mabooo18/Hunstat2/Software/README.md

## Files in this folder

- Arduino libraries: This folder includes the three files required for the HunStat2 firmware.
Copy these files into your local Arduino/libraries/ folder before compiling and uploading the firmware to the microcontroller.
- [AD5941_25.zip](AD5941_25.zip): This ZIP archive contains the complete Arduino project, including the .ino, .cpp, and header files required to compile and upload the HunStat2 firmware.
- [HunStat2-v700.exe](HunStat2-v700.exe):This is the Windows installer for the HunStat2 graphical user interface (GUI), which serves as the main program for controlling the potentiostat.
