mabooo18/Hunstat2/laporan/FLOWCHART.md

# Flowchart Panggilan Kode (Call Flow Chart)

Diagram di bawah ini menggambarkan bagaimana modul-modul program saling berinteraksi, mulai dari file utama (**Main Orchestrator**), parser perintah serial (**Communication Layer**), hingga ke submodul **Hardware** dan **Metode Elektrokimia** di dalam folder `src/`.

---

## Diagram Alur Arsitektur (Mermaid Flowchart)

```mermaid
graph TD
    %% Styling Node Warna Premium
    classDef main fill:#1E293B,stroke:#38BDF8,stroke-width:2px,color:#FFF;
    classDef comm fill:#0F766E,stroke:#0D9488,stroke-width:2px,color:#FFF;
    classDef methods fill:#1D4ED8,stroke:#3B82F6,stroke-width:2px,color:#FFF;
    classDef hw fill:#701A75,stroke:#D946EF,stroke-width:2px,color:#FFF;
    classDef utils fill:#7C2D12,stroke:#F97316,stroke-width:2px,color:#FFF;

    %% Definisi Node
    INO["AD5941_25.ino (Loop Utama)"]:::main
    Comm["C_Communication::ReadAndProcess()<br>(src/communication/)"]:::comm
    CV_Main["cv.cpp (cvSetup & Run)"]:::main
    
    CA["c_ca.cpp<br>(C_CA::Run)"]:::methods
    SWV["c_swv.cpp<br>(C_SWV::Run)"]:::methods
    DPV["c_dpv.cpp<br>(C_DPV::Run)"]:::methods
    EIS["c_eis.cpp<br>(C_EIS::Run)"]:::methods
    OCP["c_ocp.cpp<br>(C_OCP::Measure)"]:::methods
    
    Ramp["rampTest.cpp<br>(AppRAMPInit / AppRAMPISR)"]:::methods
    
    WG["wave_gen.cpp<br>(Hardware_Do_WaveGen)"]:::hw
    ADC["adc_control.cpp<br>(init_AD5940_ADC)"]:::hw
    GC["gain_control.cpp<br>(Hardware_FindOptimum_Rf_PGA)"]:::hw
    
    Util["utilities.cpp<br>(ToFloat / Status LED)"]:::utils
    Storage["data_storage.cpp<br>(Global g_Data)"]:::utils

    %% Alur Hubungan (Call Hierarchy)
    INO -->|1. Polling Serial secara berkala| Comm
    
    %% Cabang Pengiriman Command
    Comm -->|2a. Jalankan CA| CA
    Comm -->|2b. Jalankan SWV| SWV
    Comm -->|2c. Jalankan DPV| DPV
    Comm -->|2d. Jalankan EIS| EIS
    Comm -->|2e. Jalankan OCP| OCP
    Comm -->|2f. Jalankan CV M| CV_Main
    
    %% Alur CV via Sequencer
    CV_Main -->|3. Siapkan Sequencer| Ramp
    Ramp -->|4. Trigger hardware WUPT timer| AFE_Seq["AD5941 SRAM Sequencer"]:::hw
    AFE_Seq -->|5. Interrupt Pin A2 Aktif| ISR_Call["XIAOPort.cpp (Falling ISR)"]:::hw
    ISR_Call -->|6. Panggil Handler| Ramp
    
    %% Interaksi ke Hardware/PGA/Filter
    EIS -->|Set sinyal AC sinus| WG
    WG -->|Optimasi otomatis Gain| GC
    EIS -->|Set Sinc filters / DFT| ADC
    
    %% Parsing Data & Dekode 18-bit signed
    CA -->|7. Dekode biner| Util
    SWV -->|7. Dekode biner| Util
    DPV -->|7. Dekode biner| Util
    OCP -->|7. Dekode biner| Util
    EIS -->|7. Dekode biner| Util
    Ramp -->|7. Dekode biner| Util
    
    %% Penyimpanan koordinat data
    CA -->|8. Simpan data| Storage
    SWV -->|8. Simpan data| Storage
    DPV -->|8. Simpan data| Storage
    OCP -->|8. Simpan data| Storage
    EIS -->|8. Simpan data| Storage
    Ramp -->|8. Simpan data| Storage
    
    Storage -->|9. Kirim koordinat ke serial| Host["Komputer / Python UI"]:::main
```

---

## Penjelasan Alur Interaksi

1. **Orkestrator Utama (`AD5941_25.ino`)**:
   * Menjalankan fungsi `loop()` secara terus-menerus.
   * Melakukan polling ke `C_Communication::ReadAndProcess()` untuk membaca perintah yang dikirim komputer lewat USB Serial.

2. **Parser Perintah (`src/communication/`)**:
   * Membaca buffer serial dan membagi perintah (tokenisasi).
   * Melakukan *routing* panggilan langsung ke kelas metode elektrokimia yang sesuai di `src/electrochemical_methods/` (seperti `c_eis.cpp`, `c_ca.cpp`, dll).

3. **Metode Non-Ramp (CA, SWV, DPV, OCP, EIS)**:
   * Mengatur bias tegangan sel menggunakan Low-Power DAC secara langsung.
   * Menghubungi modul hardware untuk inisialisasi filter (`adc_control.cpp`) atau generator gelombang AC (`wave_gen.cpp`).
   * Menunggu jeda kimiawi (*settling delay*).
   * Membaca hasil register konversi ADC, mengubah nilai biner 18-bit ke bentuk float voltase/arus (`utilities.cpp`), menyimpannya di memori (`data_storage.cpp`), lalu mengirimkannya ke Serial.

4. **Metode Ramp (Cyclic Voltammetry / CV)**:
   * Karena memerlukan kecepatan tinggi, CV memanggil konfigurasi di `cv.cpp` yang meneruskannya ke mesin sequencer `rampTest.cpp`.
   * Perintah dirangkai langsung di memori SRAM AD5941. Saat berjalan, chip mengaktifkan jalur interrupt MCU (`A2`) setiap kali selesai membaca step.
   * Fungsi `AppRAMPISR()` mengambil data dari FIFO chip, merata-ratakannya, lalu melakukan konversi dan penyimpanan.

---

## Catatan Tambahan (hasil verifikasi kode terbaru)

Dua hal berikut tidak terlihat dari diagram di atas karena diagram hanya menggambarkan jalur pemanggilan yang **aktif**:

1. **Jalur mati yang ikut ter-compile tapi tidak pernah dipanggil.** Selain `Comm` (`src/communication/communication.cpp`, jalur yang benar-benar dijalankan oleh `AD5941_25.ino`), ada satu set implementasi lama yang duplikat: `src/command_processing/command_processing.cpp` (parser serial versi prosedural) dan bagian atas `src/electrochemical_methods/electrochemical_methods.cpp` (fungsi bebas `RunCA`/`RunSWV`/`RunDPV`). Arduino tetap meng-compile kedua file ini karena berada di dalam folder sketch, tapi tidak ada satu pun pemanggil di `loop()` yang mengarah ke sana — jadi keduanya tidak pernah tereksekusi. Selengkapnya di `ARCHITECTURE_DOCUMENT.md` §3.4/§8 dan `TECHNICAL_REPORT_EN.md` §5.
2. **Transport SPI ke AD5941 sekarang bit-banged, bukan `SPI` hardware bawaan RP2040.** Node `XIAOPort.cpp` di diagram di atas kini mengimplementasikan SPI Mode 0 secara manual lewat `digitalWrite`/`digitalRead` pada pin `D8`/`D9`/`D10`, karena wiring board ini menukar posisi MISO/MOSI dibanding pin-mux SPI0 bawaan XIAO RP2040. Detail lengkap di `TECHNICAL_REPORT_EN.md` §4.1 dan §7.4.

---

# Part 2 — How the AD5941 Actually Works (Signal-Level Flowcharts)

The diagrams above describe the *software* call graph — which function calls which. This part is a different, complementary view: how a voltage command actually becomes a physical measurement, tracing signal flow through the PC, the microcontroller, the AD5941's internal analog blocks, the electrode connector, and the electrochemical cell itself. It mirrors the block-diagram set from the project's internal "Update Potensiostat" presentation, redrawn here in English and cross-checked line-by-line against the firmware described in Part 1 and in `ELECTROCHEMICAL_METHODS_EXPLANATION.md` / `TECHNICAL_REPORT_EN.md`.

## 1. System Block Diagram

```mermaid
graph TD
    subgraph PC[PC Software - HunStat2 Windows GUI]
        CVtab[CV tab]
        OCPtab[OCP tab]
        EIStab[EIS tab]
        SPtab[Signal processing tab]
    end

    MCU[Microcontroller - Seeed XIAO RP2040<br/>runs the Arduino sketch, bit-banged SPI interface]

    subgraph AFE[AD5941 Analog Front End chip]
        DAC[DAC<br/>Vzero six bit plus Vbias twelve bit]
        WG[Waveform Generator<br/>DC ramp or AC sine, 0.2 Hz to 200 kHz]
        TIA[TIA - transimpedance amplifier<br/>converts cell current to a voltage]
        ADCPGA[ADC plus PGA<br/>16 bit sigma delta ADC, five gain steps]
        DFT[DFT / DSP engine<br/>computes Z real and Z imag for EIS]
        LOOP[Potentiostat control loop<br/>CE driver regulates the WE potential]
        PWR[Power management<br/>LDO and bandgap bias references]
    end

    subgraph PASSIVE[Board level passive components]
        DECAP[Decoupling capacitors]
        FBRES[Feedback resistors, including RCAL]
        EMI[EMI filter inductor]
        JUMP[Zero ohm jumpers]
        SW[Tactile switches]
    end

    subgraph ELEC[Electrode interface - 3 pin SPE connector]
        WE[WE - working electrode]
        CE[CE - counter electrode]
        RE[RE - reference electrode]
    end

    CELL[Electrochemical cell or Screen-Printed Electrode<br/>for example a carbon or gold SPE]

    PC -- USB-C --> MCU
    MCU -- SPI --> DAC
    DAC --> WG --> TIA --> ADCPGA
    ADCPGA --> DFT
    LOOP -.regulates.-> WG
    PWR -.powers.-> DAC
    ADCPGA --> DECAP
    DECAP --> FBRES --> EMI --> JUMP --> SW
    SW --> WE
    SW --> CE
    SW --> RE
    WE --> CELL
    CE --> CELL
    RE --> CELL
```

Compared to the presentation slide this is redrawn from: the ADC/PGA block there is captioned "gain 1 to 512", but the firmware actually only exposes five discrete PGA steps (1.0x, 1.5x, 2.0x, 4.0x, 9.0x — `gain_control.cpp`'s `pga_values[]`). The wider number almost certainly refers to the *combined gain* range achievable once the eight TIA feedback resistor steps (200 Ω … 160 kΩ) are multiplied in — see `TECHNICAL_REPORT_EN.md` §3.4 for the exact interpolation formula used to pick both automatically.

## 2. Excitation Signal Path (PC to Cell)

```mermaid
graph LR
    GUI[PC GUI<br/>parameters: E start, E end, frequency, delta E]
    PARSE[RP2040 MCU<br/>parses the serial command, relays it over SPI]
    DAC2[DAC inside the AD5941<br/>Vzero six bit / Vbias twelve bit]
    WG2[Waveform generator]

    GUI -- USB-C command --> PARSE
    PARSE -- SPI register writes --> DAC2
    DAC2 -- analog voltage --> WG2

    WG2 --> RAMP[DC ramp or staircase<br/>used by CV, DPV, OCP]
    WG2 --> SINE[AC sinusoidal<br/>used by EIS, 0.2 Hz to 200 kHz]
    WG2 --> PULSE[Staircase plus pulse<br/>used by DPV and SWV]

    RAMP --> PLOOP[Potentiostat loop<br/>CE driver holds the WE at the target potential]
    SINE --> PLOOP
    PULSE --> PLOOP

    PLOOP -- excitation E of t --> CELL2[CE and WE pins on the SPE<br/>excitation delivered to the cell]
```

This matches the firmware's per-method `ConfigDCMeasurement()`/`Hardware_Do_WaveGen()` split described in `ELECTROCHEMICAL_METHODS_EXPLANATION.md`: CA/DPV/SWV/OCP drive a static or stepped DC level through the `WGTYPE_MMR` path, while EIS drives a continuous sine through `WGTYPE_SIN`. Both paths ultimately write the same `HpLoopCfg.WgCfg` structure.

## 3. Potentiostat Feedback Loop (Detail)

This is the core control loop that makes a *potentiostat* a potentiostat: it forces the working electrode's potential to track a target value by adjusting the counter electrode, rather than by driving the working electrode directly.

```mermaid
graph TD
    subgraph CHIP[Inside the AD5941]
        DAC3[DAC<br/>builds the target E set]
        OPAMP[Op-amp<br/>the CE driver]
        ERR[Error amplifier<br/>compares E RE against E set]
        DAC3 --> OPAMP
    end

    subgraph SPE2[Screen-Printed Electrode - 3 electrodes on 1 substrate]
        CE2[CE - counter electrode]
        WE2[WE - working electrode]
        RE2[RE - reference electrode]
    end

    SOL[Electrolyte solution<br/>ions carry current between electrodes]
    REDOX[Redox reaction at the WE surface<br/>produces the response current I of t]
    TIA2[TIA<br/>current to voltage conversion]
    ADC2[16 bit ADC<br/>digitizes I of t]
    MCUOUT[RP2040 to PC GUI<br/>current data streamed over USB]

    OPAMP -- V CE drives --> CE2
    CE2 --> SOL --> WE2 --> REDOX --> TIA2 --> ADC2 --> MCUOUT
    RE2 -- E RE feedback --> ERR
    ERR -- correction signal --> OPAMP
```

**Why the loop is closed through the reference electrode, not the working electrode:** the whole point of a 3-electrode cell (§1.2 of `ELECTROCHEMICAL_METHODS_EXPLANATION.md`) is that no current is allowed to flow through the RE, so its potential never drifts from Faradaic reactions at its own surface. If `E_RE` measured against `E_set` shows an error, the op-amp keeps adjusting `V_CE` — never `V_WE` directly — until the RE reports the correct potential. All the current needed to sustain that potential is supplied or sunk through the CE instead.

## 4. Generate, React, Detect — The Three-Stage View

A simpler way to see the same loop: as three stages that data flows through once per excitation step (once per CV/DPV/SWV point, or continuously for CA/EIS/OCP sampling).

```mermaid
graph LR
    subgraph GEN[1. GENERATE - build the excitation voltage]
        DACg[DAC inside the AD5941<br/>builds E set: ramp, sine, or staircase]
        DRVg[CE driver op-amp<br/>amplifies and sends it to the CE pin]
        DACg --> DRVg
    end

    subgraph CELL3[2. In the cell - the SPE - reaction happens here]
        CEc[CE<br/>pumps current into the solution]
        WEc[WE<br/>where the reaction of interest happens]
        REc[RE<br/>senses the cell potential]
        SOLc[Electrolyte solution<br/>ion current]
        RXc[Redox reaction<br/>oxidized species plus electron gives reduced species, producing I of t]
        CEc --> SOLc --> WEc --> RXc
    end

    subgraph DET[3. DETECT - read the resulting current]
        TIAd[TIA<br/>current times feedback resistance gives a voltage]
        PGAd[PGA plus 16 bit ADC<br/>amplifies and digitizes, down to roughly 54 pA resolution]
        DFTd[DSP / DFT engine<br/>computes Z real and Z imag, EIS only]
        MCUd[RP2040 MCU<br/>packages the data, sends it over USB-C]
        GUId[PC GUI<br/>plots the voltammogram or Nyquist curve]
        TIAd --> PGAd --> DFTd --> MCUd --> GUId
    end

    DRVg -- V CE to the CE pin --> CEc
    RXc -- current I of t --> TIAd
    REc -- E RE feedback to the comparator --> DRVg
```

**Why three electrodes, in one line each:** CE pumps whatever current the loop needs into the solution; WE is the fixed, characterized surface where the reaction under study actually happens; RE is a low-current sensor that tells the loop what potential the WE is really sitting at, so the loop can correct for it.

## 5. Response Signal Path (Cell back to PC)

```mermaid
graph LR
    WEr[WE on the SPE<br/>outgoing response current I of t]
    TIAr[TIA<br/>current to voltage via the feedback resistor]
    PGAr[PGA plus ADC<br/>selectable gain, 16 bit]
    DFTr[DSP / DFT engine]

    WEr -- I of t, analog current --> TIAr
    TIAr -- V TIA, analog voltage --> PGAr
    PGAr -- 16 bit digital samples --> DFTr

    DFTr --> ItSig[I of t signal - used by CA, CV, DPV, SWV<br/>peak or decay current is extracted directly]
    DFTr --> ZwSig[Z of omega signal - used by EIS<br/>the DFT engine yields Z real plus j Z imag per frequency]
    DFTr --> ESig[E signal - used by OCP<br/>settles to a stable open circuit potential]

    ItSig --> RESULT[Result streamed back to the PC for display and analysis]
    ZwSig --> RESULT
    ESig --> RESULT

    RESULT --> GUIr[PC GUI]
    GUIr --> MCUr[RP2040 MCU]
    MCUr -- plotted / exported data --> SPr[Signal processing tab<br/>Savitzky-Golay filtering or moving average]
```

For CA/SWV/DPV this path runs through `MeasureCurrentRaw()`/`RawToCurrent()` once (CA) or twice (SWV/DPV, forward+reverse or base+pulse) per step — see `ELECTROCHEMICAL_METHODS_EXPLANATION.md` §3–§6. For EIS the same TIA/PGA/ADC hardware feeds the on-chip DFT accelerator instead of a single Sinc2 sample, producing one complex `(Z_real, Z_imag)` pair per frequency point — see §7 there and §3.3/§6 of `TECHNICAL_REPORT_EN.md`.

## 6. Practical Guide — Choosing RCAL, `tia_rf`, and Gain for a Given Sample

The auto-gain formula in `TECHNICAL_REPORT_EN.md` §3.4 picks a TIA resistor and PGA gain automatically from `CGMax`/`CGMin`, but those two limits still have to be set sensibly for the impedance range you actually expect from the sample. `RCAL` (the on-board calibration resistor selected in hardware, decoded to the firmware via `tia_rf`) should be chosen to sit near the middle of the sample's expected impedance range — too small and the TIA output barely moves for the current involved; too large and it saturates.

| RCAL | `tia_rf` (`r`) | `amplitude` (`z`/`Y`) | `_CGmax` (`t`) | `_CGmin` (`u`) | Typical measured Z range | Good for |
|---|---|---|---|---|---|---|
| 3.3 Ω | `r0` (200 Ω) | `z20` (≈8 mV) | 1000 | 300 | ~0.3 Ω – 330 Ω | Metals, carbon electrodes, low-ESR Li-ion cells |
| 4.7 Ω | `r0` (200 Ω) | `z30` (≈12 mV) | 1500 | 400 | ~0.5 Ω – 470 Ω | Batteries, supercapacitors, active corrosion |
| 200 Ω | `r1` (1 kΩ) | `z60`/`Y40`-`Y80` (≈24 mV) | 5000 | 1500 | ~20 Ω – 20 kΩ (sweet spot 100 Ω – 1 kΩ) | Dilute-to-moderate electrolytes (1x PBS ≈100–300 Ω, 0.1 M NaCl ≈200 Ω), impedimetric biosensors, pH/ion-selective electrodes, electrodeposition baths |
| 10 kΩ (default) | `r3` (10 kΩ) | `z126`/`Y126` (≈50 mV) | 30000 | 7500 | ~1 kΩ – 100 kΩ (sweet spot 5 kΩ – 50 kΩ) | Very dilute electrolytes and deionized water, polymer/membrane films (e.g. Nafion), soil/sediment EIS, semiconductor and solar-cell junction characterization |

The `c<value>` serial command sets `fRcal` (the *value* used in the Nyquist math, §6 of `ELECTROCHEMICAL_METHODS_EXPLANATION.md`) — it must match whichever physical RCAL resistor is actually populated on the board, since `C_EIS::CalculateNyquistCurve()` scales every impedance point by `fRcal` directly. Setting `c` to a value that doesn't match the installed resistor produces a Nyquist plot that is correctly *shaped* but wrong in *scale* by a constant factor.
