mabooo18/Hunstat2/update (1 august 26)/laporan/ELECTROCHEMICAL_METHODS_EXPLANATION.md

# How Electrochemical Methods Work in Code (AD5941)

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

---

## 1. What is an Electrochemical Method and How Does It Work?

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

```
       [ Potentiostat Control Feedback Loop ]
                 |                  |
                 v                  v
         +---------------+  +---------------+
         |   RE Pin      |  |    CE Pin     |
         | (Reference)   |  |   (Counter)   |
         +---------------+  +---------------+
                 |                  |
                 v                  v
            ==============================
                  ELECTROCHEMICAL CELL
            ==============================
                          |
                          v
                  +---------------+
                  |    WE Pin     | ----> [ Transimpedance Amp (TIA) ]
                  |   (Working)   |               |
                  +---------------+               v
                                          [ 16-Bit Sigma-Delta ADC ]
                                                  |
                                                  v
                                          [ Raw Digital Code ]
```

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

---

## 2. The Core AD5941 Loop: Voltage Excitation & Current Readback

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

```mermaid
graph TD
    subgraph CHIP[Inside the AD5941]
        DAC3[DAC<br/>builds the target E set]
        OPAMP[Op-amp<br/>the CE driver]
        ERR[Error amplifier<br/>compares E RE against E set]
        DAC3 --> OPAMP
    end

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

    OPAMP -- V CE drives --> CE2
    CE2 --> SOL --> WE2 --> REDOX --> TIA2 --> ADC2 --> MCUOUT
    RE2 -- E RE feedback --> ERR
    ERR -- correction signal --> OPAMP
```

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

### 2.1. What the HSTIA Registers Actually Configure

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

> **A related, still-open gap found 2026-08-01**: the switch-matrix line just above this table, `HpLoopCfg.SWMatCfg.Nswitch = SWN_SE0`, is hardcoded identically in `C_CA`, `C_SWV`, and `C_DPV` — there is no serial command or config path anywhere in the firmware to route a different physical working-electrode pin. A live test against a 3-branch dummy cell (one nonlinear diode branch, two plain-resistor/RC branches — see `UPDATE_2026-08-01.md` §2) produced flat, noisy CA/SWV traces with no discernible peak; the leading hypothesis is that `SE0` isn't wired to the one branch capable of producing a peaked response, which this firmware currently has no way to change without rewiring the board. See `ARCHITECTURE_DOCUMENT.md` §9, item 5.

---

## 3. Chronoamperometry (CA) in Code

**Goal**: Apply a single constant voltage to the cell and record the current decay over time.

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

---

## 4. Cyclic Voltammetry (CV) in Code

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

1. **Setup Parameters**: The variables `V_Start`, `V_Stop`, `EStep` (step size), and `ScanRate` (speed) are configured. **These are all millivolt-scale** (`RampTest.h`'s `DAC12BITVOLT_1LSB = 2200/4095 ≈ 0.537 mV` — every field in `AppRAMPCfg_Type` is mV-based, matching CA/SWV/DPV's convention elsewhere in this document). A 2026-08-01 bug in the Python UI sent these four fields in volts instead — e.g. `0.5` instead of `500` — which collapsed a normal ~700-point sweep down to exactly 2 points, since the step-count formula below effectively saw a sub-1mV total voltage swing. Fixed on the UI side (`hunstat2_test_ui.py` now converts V→mV before sending); see `UPDATE_2026-08-01.md` §3.1 for the full derivation.
2. **Sequencer Compilation (`AppRAMPInit`)**:
   * The code calculates the list of voltage steps from start to peak and back.
   * It compiles sequencer command blocks:
     * **SEQ0/SEQ1**: Commands instructing the AFE to write a new voltage step code directly to the LP-DAC register, wait for settling, and sleep.
     * **SEQ2**: Commands instructing the AFE to wake up and turn on the ADC.
3. **Trigger Sweeps (`AppRAMPCtrl`)**:
   * The **Wakeup Timer (WUPT)** is configured to run at intervals matching the scan rate.
   * On every timer tick, the hardware runs the compiled sequences:
     `Update Voltage (SEQ0/SEQ1) -> Wait Settling -> Start ADC (SEQ2) -> Capture Data`
4. **Interrupt Handling (`AppRAMPISR`)**:
   * Each time a step completes, the AFE pulls the microcontroller's interrupt pin (`A2`) LOW.
   * The RP2040 runs `AppRAMPISR()`:
     * It reads the raw samples out of the AFE's FIFO buffer.
     * It averages the samples to remove high-frequency noise.
     * It prints the resulting Voltage vs. Current coordinate over Serial.

---

## 5. Square Wave Voltammetry (SWV) in Code

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

```
Voltage
  ^
  |          Forward Pulse (V_forward = V_step + Amplitude)
  |            _
  |          /   \
  |         |     |
  |    _____|     |_____  <- Staircase Step (V_step)
  |               |     |
  |                \   /
  |                  -    <- Reverse Pulse (V_reverse = V_step - Amplitude)
  +------------------------------------------------------------> Time
```

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

---

## 6. Differential Pulse Voltammetry (DPV) in Code

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

```
Voltage
  ^
  |                       Pulse (V_pulse = V_step + Amplitude)
  |                         ________
  |                        |        |
  |                        |        |
  |    ____________________|        |____  <- Staircase Step (V_step)
  |    ^                            ^
  |    |                            |
  |  Sample Base Current          Sample Pulse Current
  |   (I_base)                     (I_pulse)
  +------------------------------------------------------------> Time
```

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

---

## 7. Electrochemical Impedance Spectroscopy (EIS) in Code

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
