mabooo18/Hunstat2/Software/update 4 (8 Agustus 26)/AD5941_25/ppt gambar.pdf

# Update Potensiostat

Dipresentasikan oleh

KENT

### 30 MEI 26

Daftar Isi:
1.Dokumen (diagram blok, RCAL)
2. Foldering Software
3. Laporan jasa Potensiostat

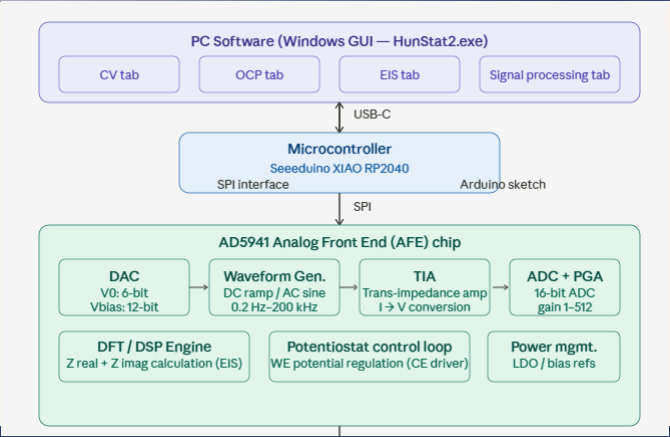
[picture p12: figure]

### 1. Dokumen (Diagram Blok)

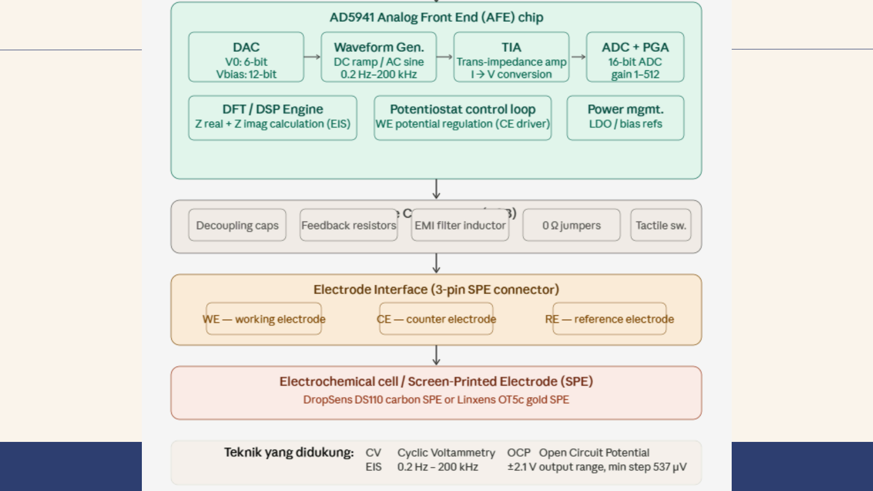
[picture p13: page 4]
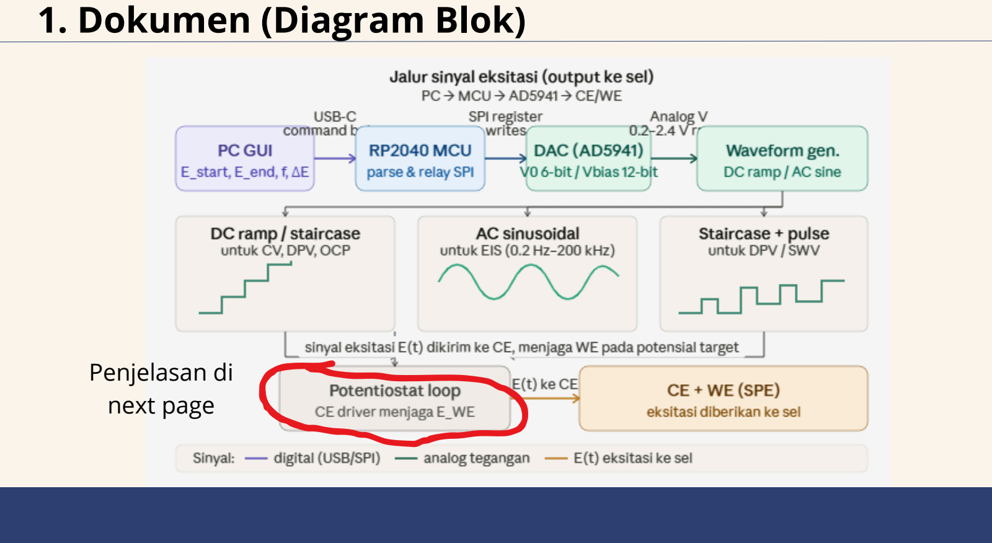
[picture p14: page 5]

### 1. Dokumen (Diagram Blok)

Penjelasan di
next page

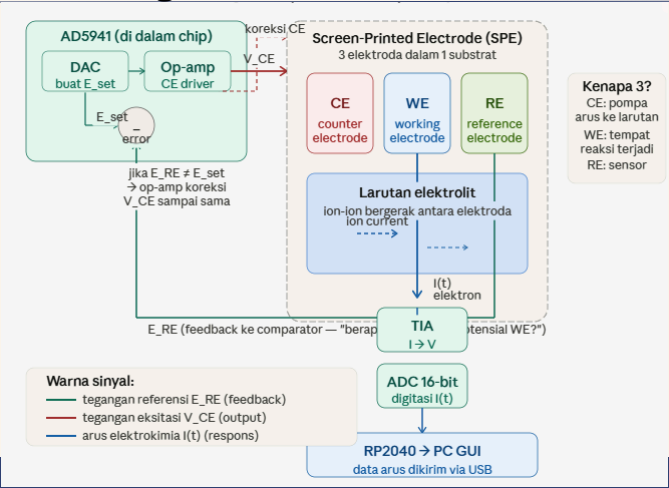
[picture p15: figure]

### 1. Dokumen (Diagram Blok)

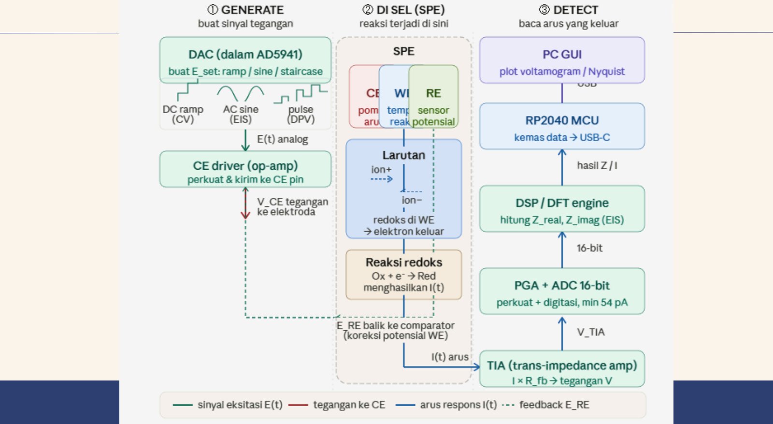
[picture p16: page 7]

### 1. Dokumen (Diagram Blok)

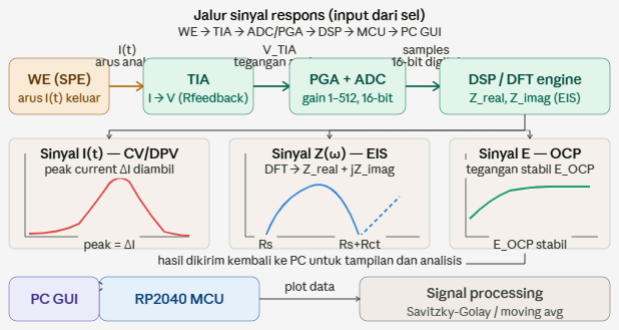
[picture p17: figure]

### 1. Dokumen (RCAL)

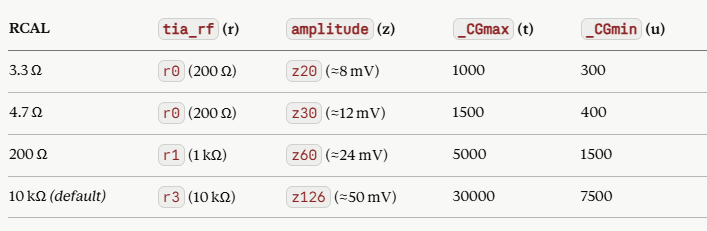
[picture p18: figure]

### 1. Dokumen (RCAL)

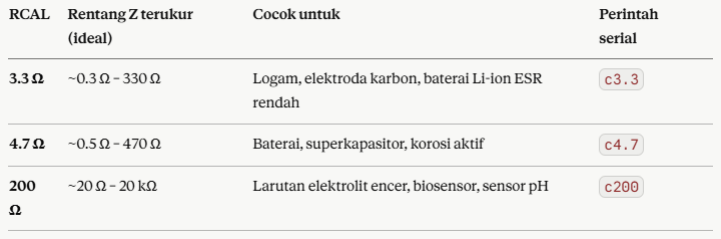
[picture p19: figure]
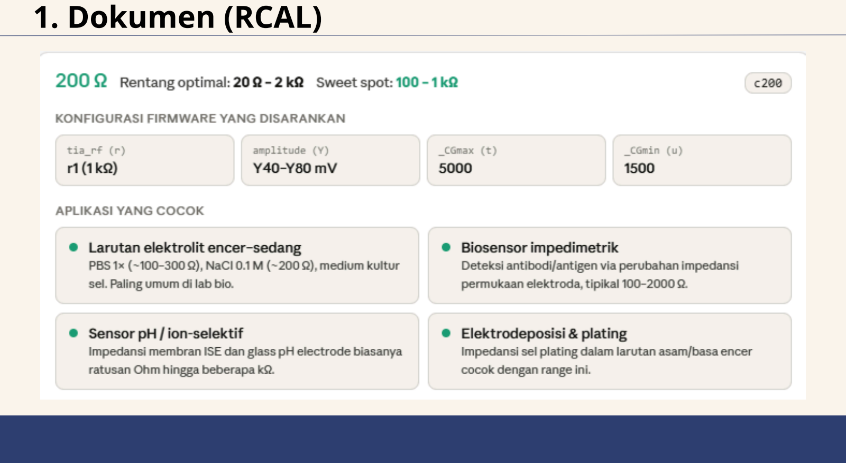
[picture p20: page 11]

### 1. Dokumen (RCAL)

### 1. Dokumen (RCAL)

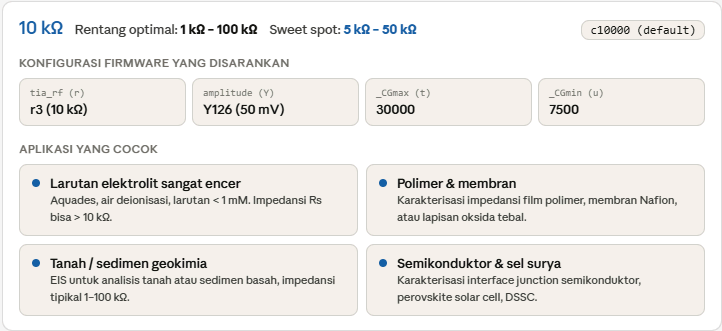
[picture p21: figure]

2.Foldering Software

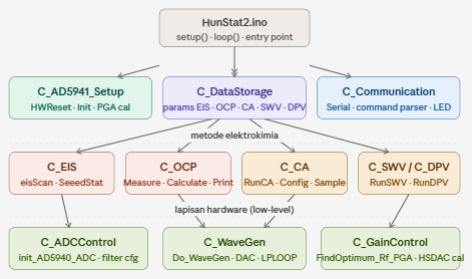
[picture p22: figure]

2.Foldering Software

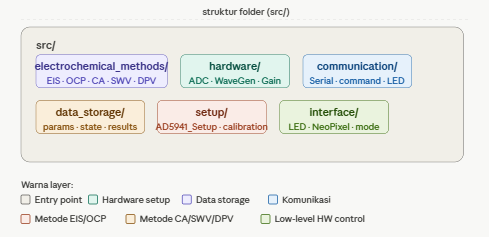
[picture p23: figure]
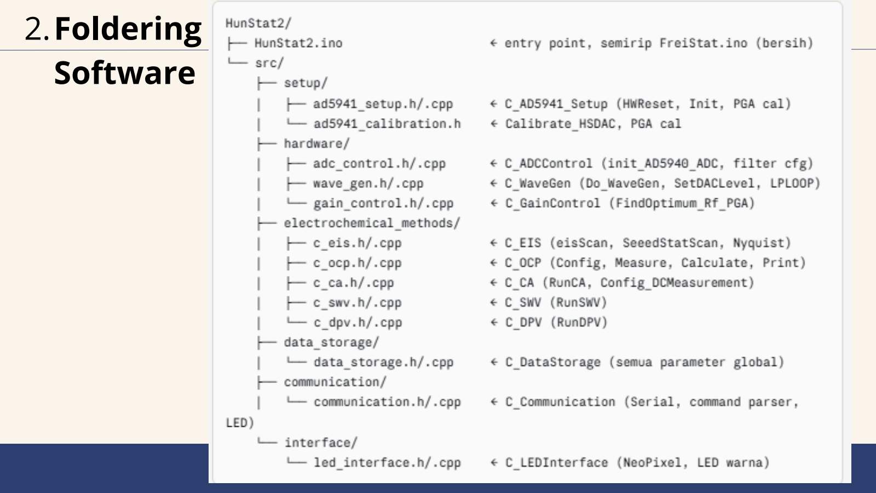
[picture p24: page 15]

2.Foldering
Software

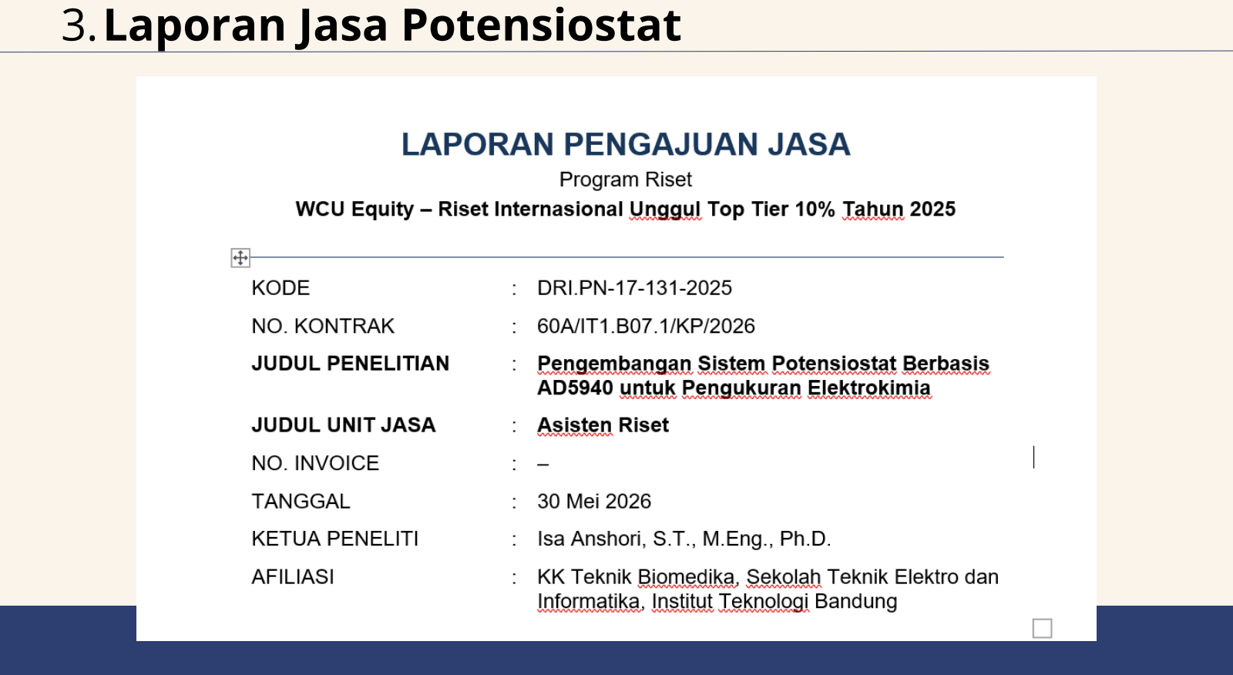
[picture p25: page 16]

3.Laporan Jasa Potensiostat
