mabooo18/Hunstat2/Software/update 4 (8 Agustus 26)/AD5941_25/hasil/dummy cell.png

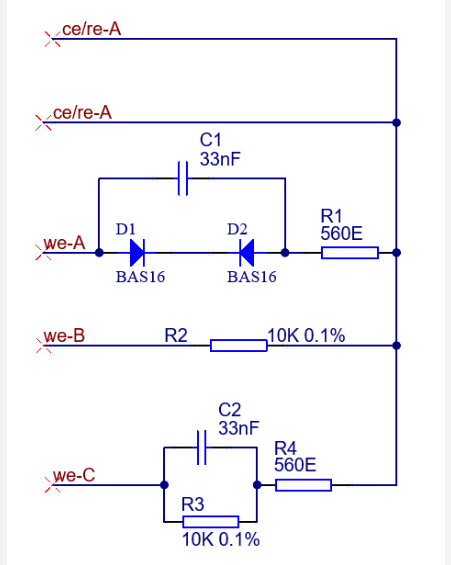
Software/update 4 (8 Agustus 26)/AD5941_25/hasil/dummy cell.png
