mabooo18/Hunstat2/Hardware/HunSta2_BOM_corr.xlsx

ID | Name | Designator | Footprint | Quantity | Manufacturer Part | Manufacturer | Supplier | Supplier Part | Price
1 | 200Ω | RCAL | R1206 | 1 | 1206W200R1% | UniOhm | LCSC | C17909 | 0.003
2 | 100nF | C4,C5,C6,C8,C9,C10,C12,C13,C15,C17,C18,C19 | C1206 | 12 | CL31B104KBCNNNC | Samsung | LCSC | C24497 | 0.014
3 | 470nF | C7,C11,C2,C3 | C1206 | 4 | CL31B474KBCNNNC | Samsung | LCSC | C1729 | 0.018
4 | 4.7uF | C14 | C1206 | 1 | CL31A475KAHNNNE | Samsung | LCSC | C29823 | 0.026
5 | 10uF | C16 | C1206 | 1 | CL31A106KBHNNNE | Samsung | LCSC | C13585 | 0.032
6 | 600Ω | L1 | L1206 | 1 | CBW321609U601T | FH | LCSC | C73732 | 0.018
7 | Push button | S1,S2 | FSM2J_1 | 2 | DNP | DNP | DNP | DNP | 0
8 | AD5941BCPZ-RL7 | U1 | LFCSP-48_L7.0-W7.0-P0.50-BL-EP5.1 | 1 | AD5941BCPZ-RL7 | Analog Devices | LCSC | C650309 | 12.497
9 | SEEED XIAO RP2040 | U2 | SEEED_XIAO_IM | 1 | DNP | DNP | DNP | DNP | 0
10 | 0Ω | R1,R2,R3 | R1206 | 3 | 1206W0R0 | UniOhm | LCSC | C19290 | 0.003
11 | 10kΩ | R4,R5,R6 | R1206 | 3 | 1206W10K1% | UniOhm | LCSC | C17902 | 0.003
12 | 220pF | C1 | C1206 | 1 | CL31C221JBCNNNC | Samsung | LCSC | C14858 | 0.012
13 | Pin header 2.54mm | H1,H2,H3 | HDR-TH_4P-P2.54-V-M | 3 | PZ254V-11-04P | XFCN | LCSC | C2691448 | 0.022
