mabooo18/Hunstat2/journal/figures/fig_ca_transient_vs_step.pdf

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

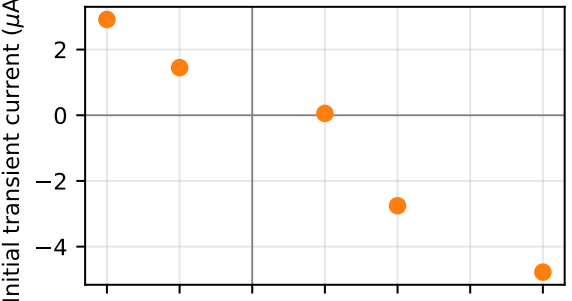
[picture p30: figure]
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
