mabooo18/Hunstat2/journal/figures/fig_ca_transient_vs_step.png

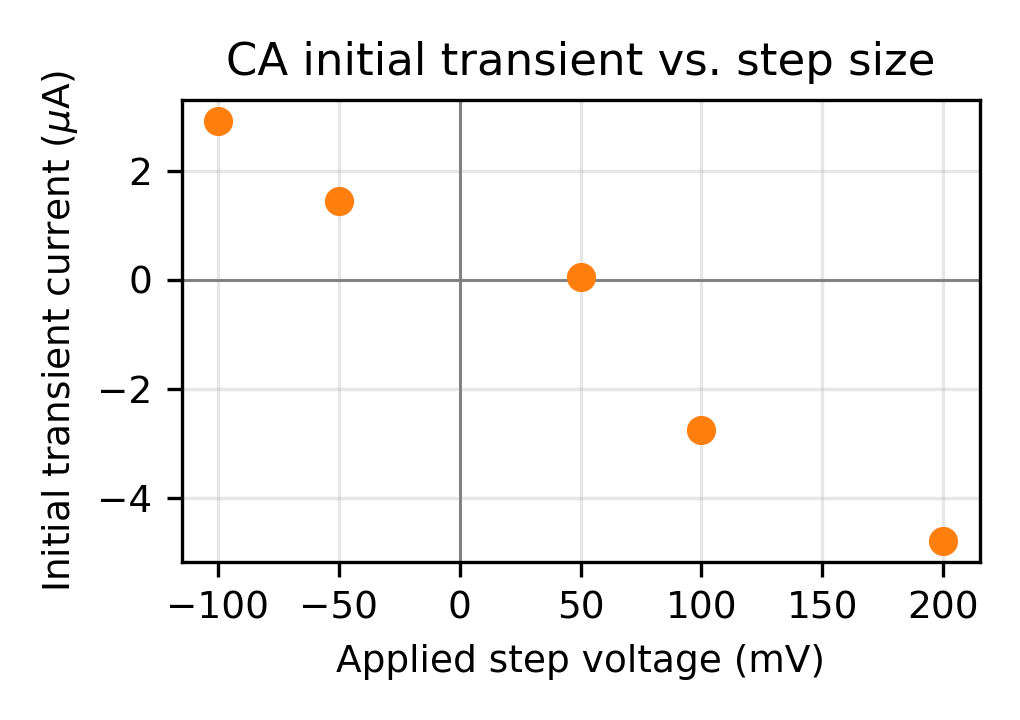
journal/figures/fig_ca_transient_vs_step.png
