mabooo18/Hunstat2/Software/update 4 (8 Agustus 26)/ad5940-examples-master/ad5940-examples-master/doc/Schematics/AD5940/Layout/AD5940 Z Test.pdf

D

1

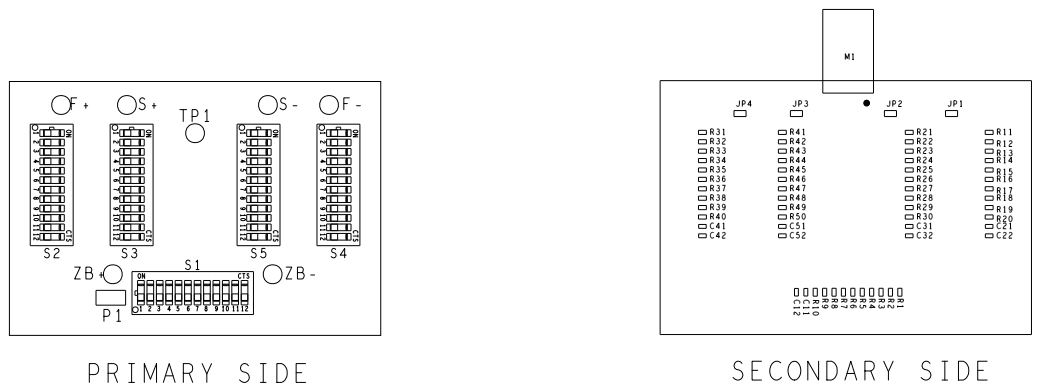
[picture p32: page 1]
ART FILM - assy1; APPROVED; DATE; REVISION; AD5940 Impedance Test; DESCRIPTION; INITIAL RELEASE; 18APR18; P SHEAHAN; ASSEMBLY; REV; ANGLES +/- 2; DECIMALS; .XXX +-0.127; SECONDARY SIDE; CTS; 12 CTS; PRIMARY SIDE

UNLESS OTHERWISE SPECIFIED
DIMENSIONS ARE IN MM
TOLERANCES
FRACTIONS

ANALOG DEVICES INTERNATIONAL

ERDC Building
Raheen Business Park
Raheen, LIMERICK, IRELAND

ART FILM - fab1

ART FILM - fab1

D

C

B

A

A

1

APPROVED

1

DATE

Raheen Business Park

ERDC Building

Raheen, LIMERICK, IRELAND

1

ANALOG DEVICES INTERNATIONAL

1

09-049393

1/1

REVISION

AD5940 Impedance Test

A3

DESCRIPTION
INITIAL RELEASE

18APR18

2

P SHEAHAN

2

FABRICATION

REV
A

ANGLES
+/- 2

TOLERANCES
FRACTIONS
+- 1/32

DIMENSIONS ARE IN MM

UNLESS OTHERWISE SPECIFIED

DECIMALS

.XXX +-0.127

.XX +-0.25

3

## TOLERANCE/NOTES

3

## QTY

61
2
1
8
2

4

## PLATED PLATED PLATED PLATED PLATED PLATED

4

## ALL UNITS ARE IN MILS

## FINISHED HOLES IN MILS

## SIZE

20.0
35.0
40.0
40.0

43.0x18.0

HOLE TOLERANCES
UNLESS SPECIFIED
PLATED: +/- 0.003"
NON PLATED: +/- 0.002"

## FIGURE

5

5

1.350

SEE
NOTE 9

6

6

1.975

7

7

Board to be fabricated per IPC-6012A, CLASS 2.

Terminal areas and plated thru holes to be ENIG plated.

A. Conductive pattern front to back registration within 0.125mm total.
B. Minimum annual ring surrounding holes 0.05mm.
C. Finished conductive pattern to be within 0.05mm of true size.
D. Minimumfeature size 0.2032mm
E. Minimum air gap 0.2032mm

colour GREEN both sides using the pattern provided. No mask is permitted on the terminal areas. Soldermask to etch registration within 0.125mm total.

Nomenclature shall be legible. Screen to etch registration within 0.15mm total.

8

FABRICATION NOTES:

1. Material: 2 Layer FR4 glass epoxy laminate 1.6mm +/- 10%. material to be RoHS compliant.
2. Plated thru holes and conductive pattern electroplated with 0.255mm min. thick copper.
3. Processing tolerence:
4. Warp and twist within 0.1875mm per 25mm (0.75%)
5. Dimensions are for the finished part.
6. SOLDERMASK: liquid Photo Imeagable soldermask over bare copper (SMOBC),
7. SCREENING: Screen component outlines and nomenclature using indelible white ink on both sides.
8. Electrically test 100%.
9. Manufacturer UL and Date codes on the bottom side silkscreen as indicated.

8

D

C

B

A

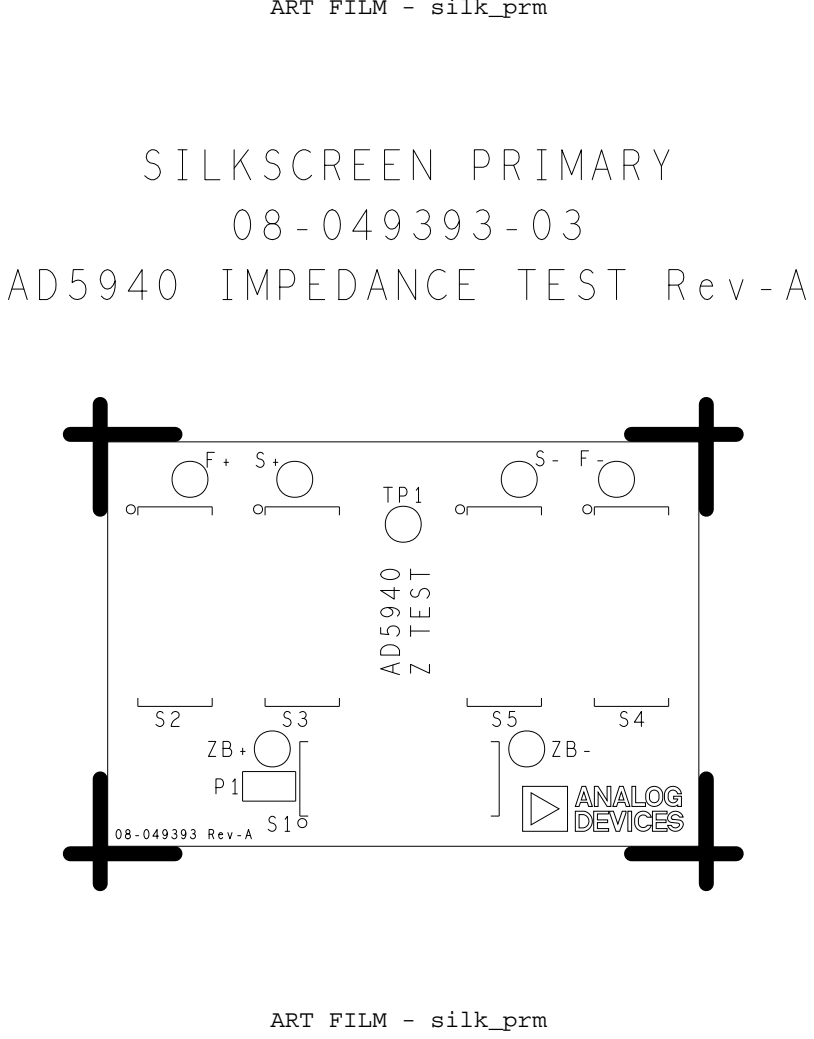
[picture p33: page 3]
ART FILM - silk_prm; TP1AD5940 Z TEST; SILKSCREEN PRIMARY; 08-049393 Rev-A

AD5940 IMPEDANCE TEST Rev-A

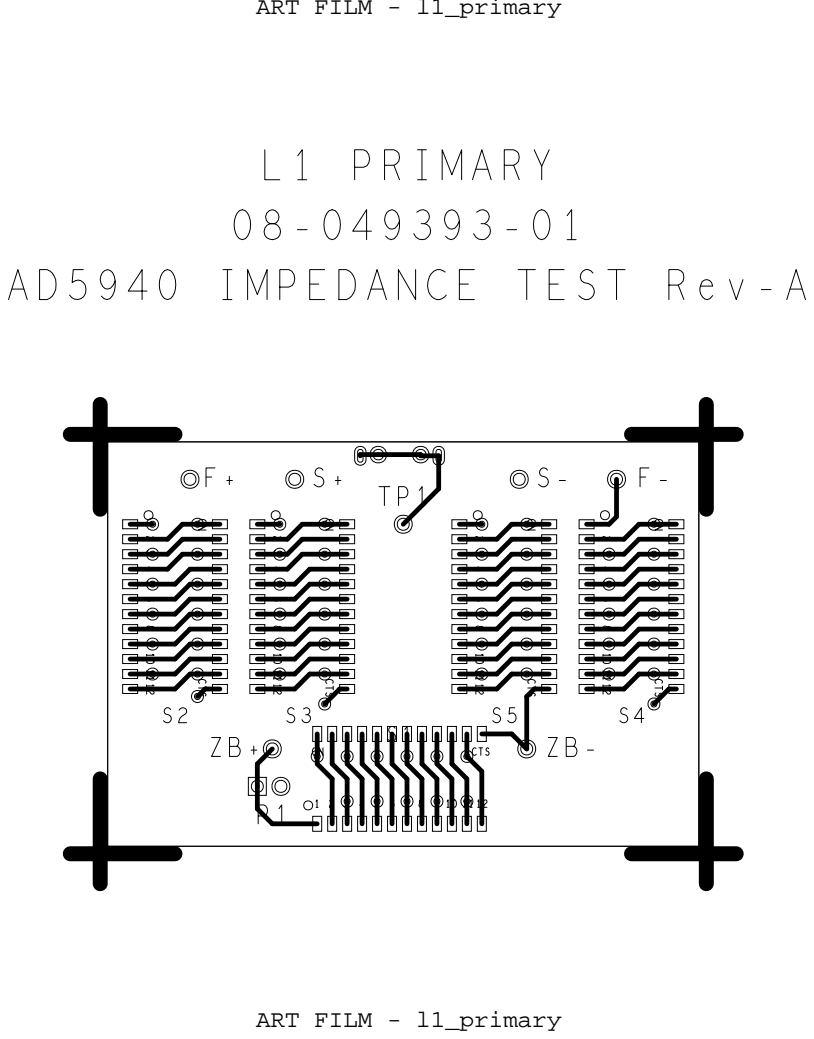
[picture p34: page 4]
ART FILM - l1_primary; CTS; 12 CTS; L1 PRIMARY

AD5940 IMPEDANCE TEST Rev-A

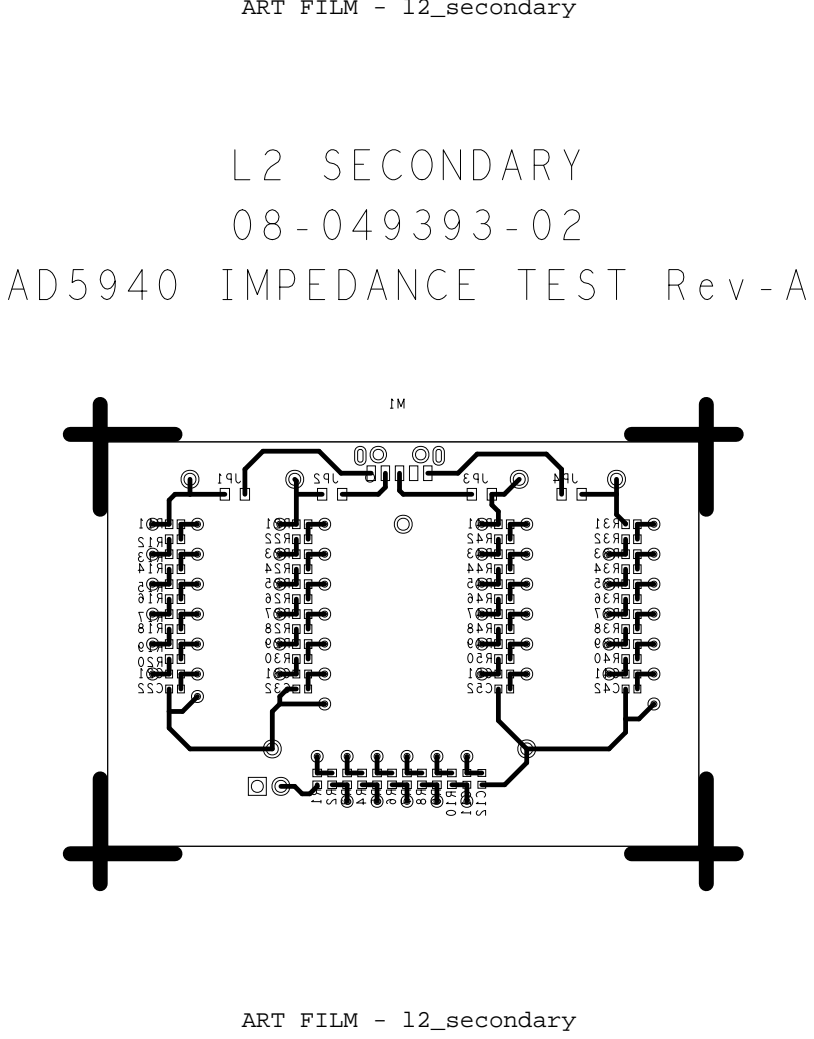
[picture p35: page 5]

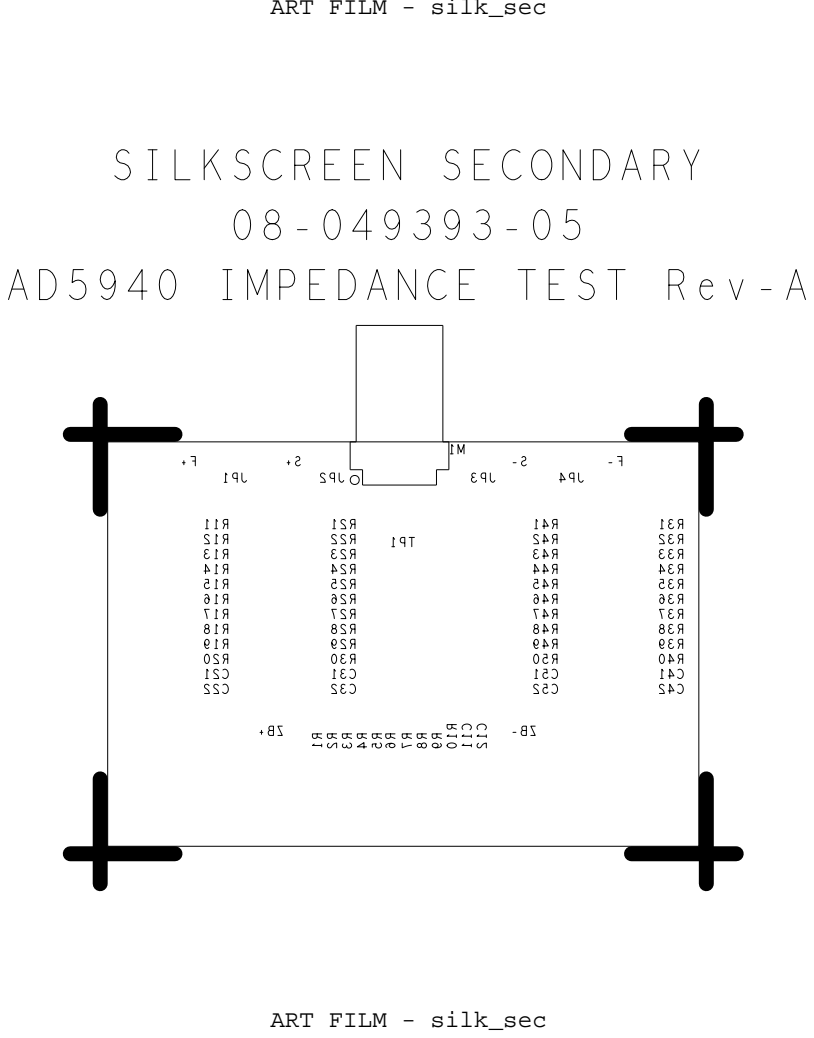
[picture p36: page 6]

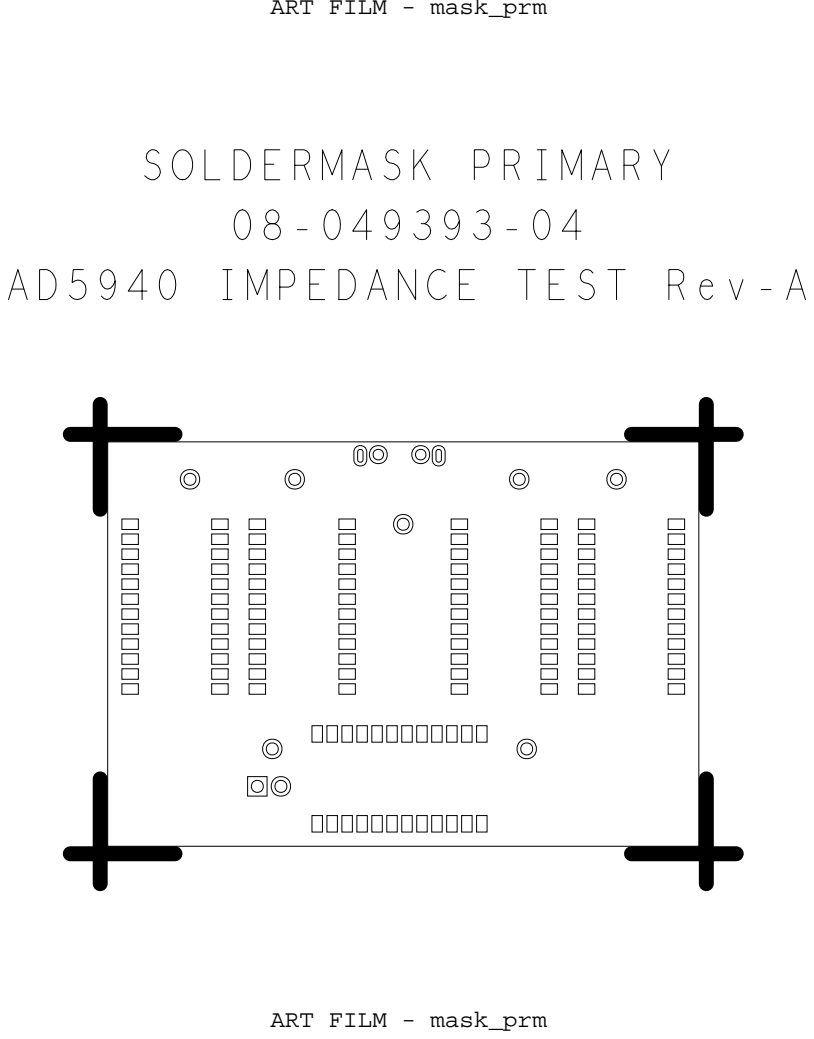
[picture p37: page 7]
ART FILM - mask_prm; SOLDERMASK PRIMARY

AD5940 IMPEDANCE TEST Rev-A

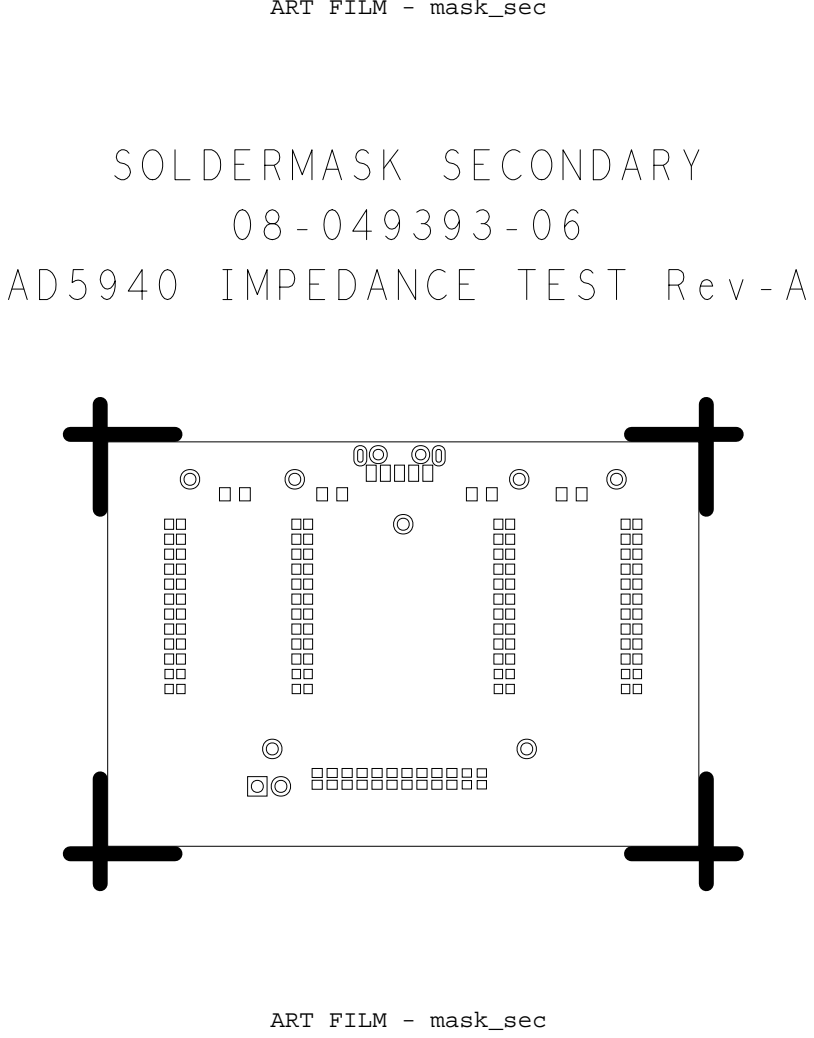
[picture p38: page 8]
ART FILM - mask_sec; SOLDERMASK SECONDARY

AD5940 IMPEDANCE TEST Rev-A

ART FILM - paste_prm

ART FILM - paste_prm

049393

PASTEMASK PRIMARY

AD5940 IMPEDANCE TEST Rev-A

ART FILM - paste_sec

ART FILM - paste_sec

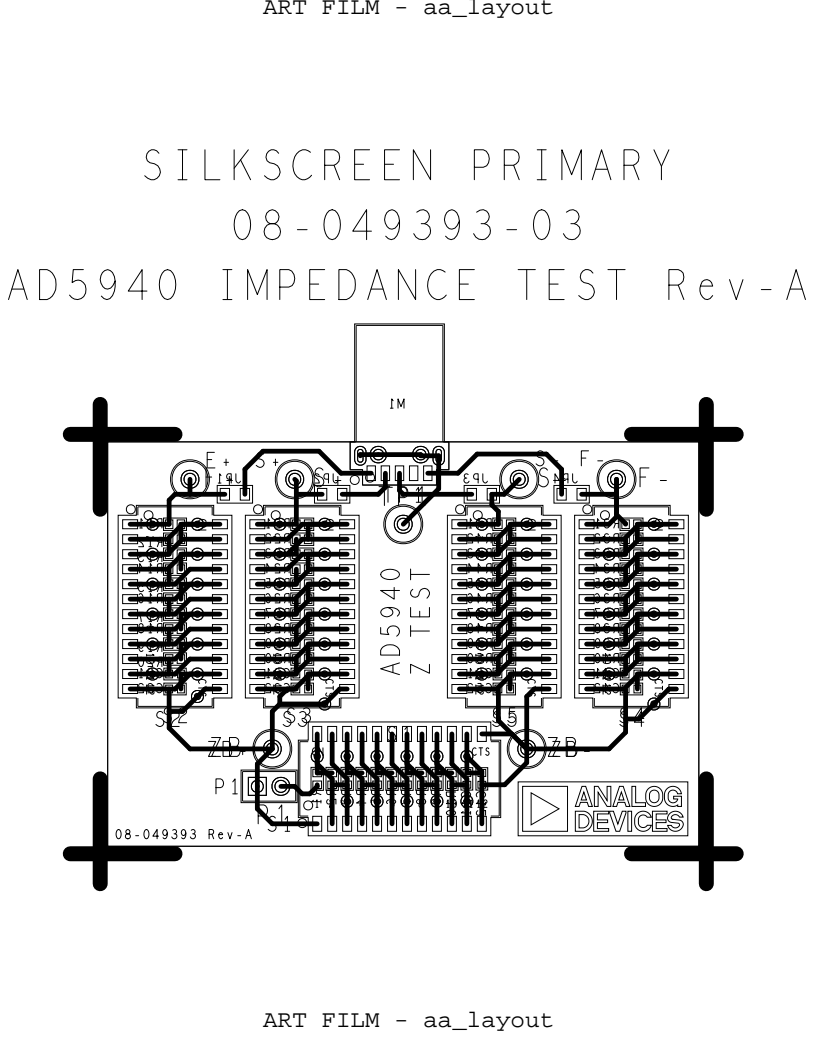
[picture p39: page 11]
ART FILM - aa_layout; CTS; 12 CTS; TP1 TP1AD5940 Z TEST; SILKSCREEN PRIMARY; 08-049393 Rev-A

AD5940 IMPEDANCE TEST Rev-A
