mabooo18/Hunstat2/Software/update 4 (8 Agustus 26)/AD5941_25/hasil_fixed/swv_test1.csv

voltage_mV | delta_current_A
-100.00 | -2.5549e-07
-90.00 | 4.7766e-07
-80.00 | 4.3323e-07
-70.00 | 3.8879e-07
-60.00 | 4.5544e-07
-50.00 | 4.2212e-07
-40.00 | 3.4991e-07
-30.00 | 3.8324e-07
-20.00 | 3.6658e-07
-10.00 | 3.7213e-07
0.00 | 3.2214e-07
10.00 | 2.3883e-07
20.00 | 2.8326e-07
30.00 | 3.0548e-07
40.00 | 2.4994e-07
50.00 | 2.9437e-07
60.00 | 3.1104e-07
70.00 | 2.6105e-07
80.00 | 2.1661e-07
90.00 | 1.7218e-07
100.00 | 2.4438e-07
