mabooo18/Hunstat2/journal/figures/fig_ca_transient.png

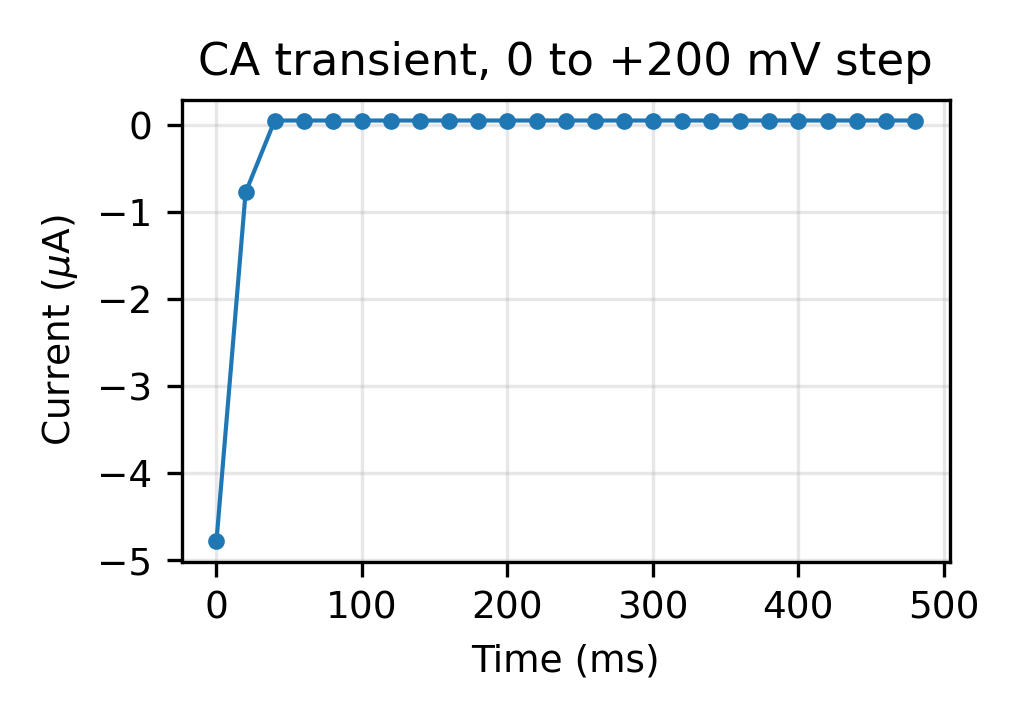
journal/figures/fig_ca_transient.png
