mabooo18/Hunstat2/journal/figures/fig_cv_linear_fit.png

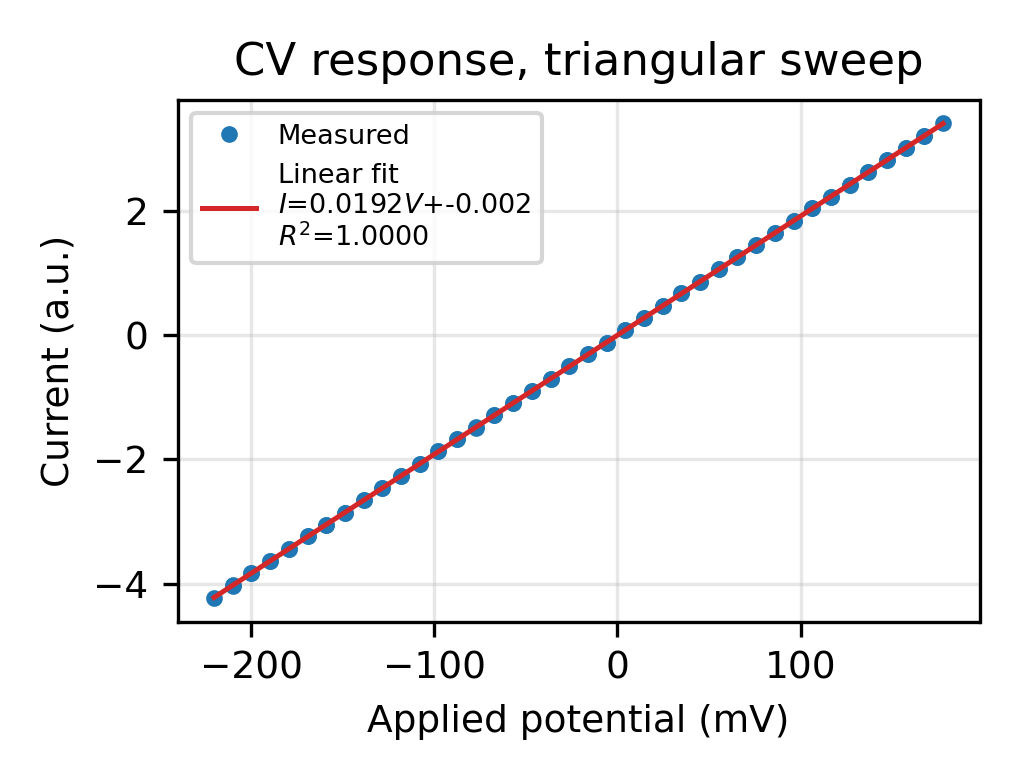
journal/figures/fig_cv_linear_fit.png
