mabooo18/Hunstat2/journal/figures/fig_dpv.png

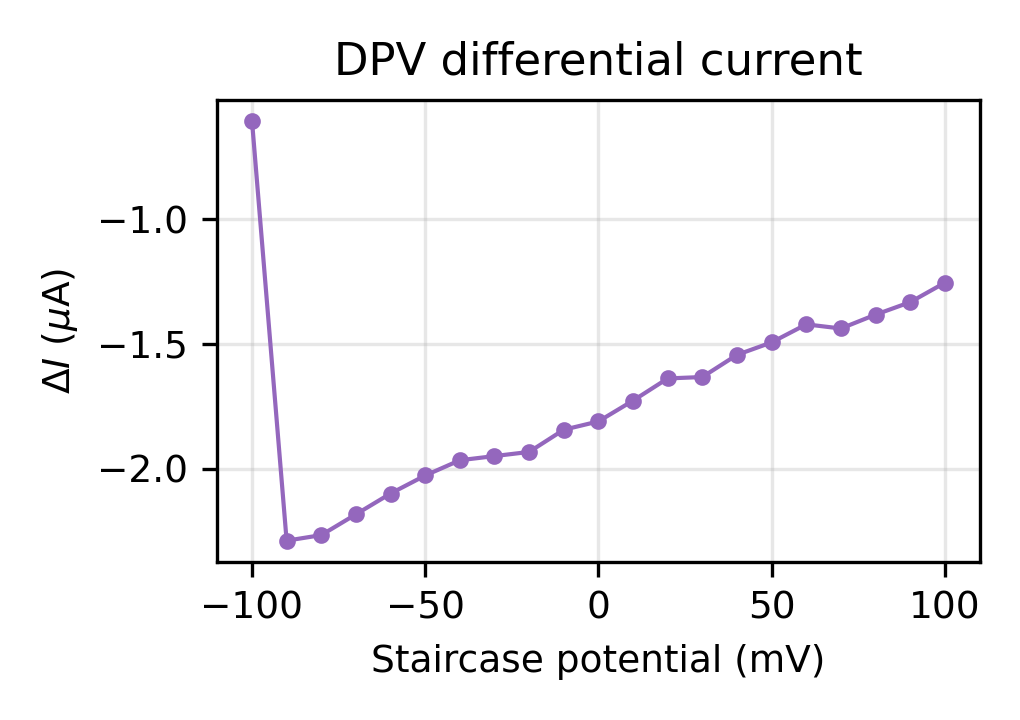
journal/figures/fig_dpv.png
