mabooo18/Hunstat2/journal/figures/fig_swv.png

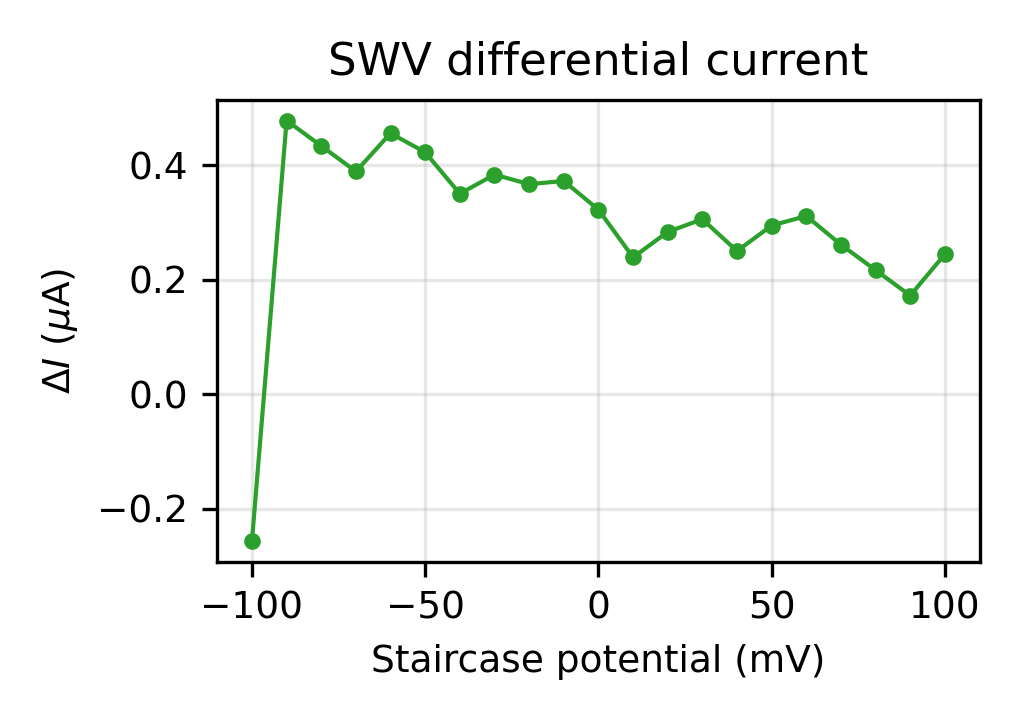
journal/figures/fig_swv.png
