mabooo18/Hunstat2/journal/figures/fig_dpv.pdf

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

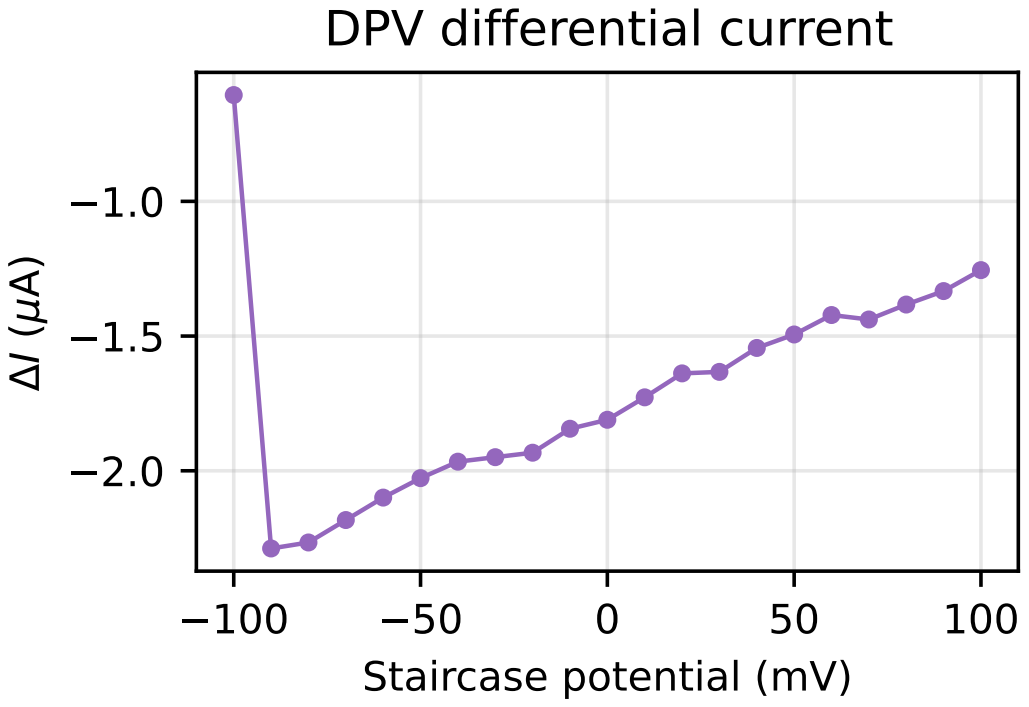
[picture p46: page 1]
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
