mabooo18/Hunstat2/Software/update 4 (8 Agustus 26)/STEI_Bstat_v1.2/STEI_Bstat_v1.2/STEI_Bstat_v1.2.kicad_pcb

## KiCad design Software/update 4 (8 Agustus 26)/STEI_Bstat_v1.2/STEI_Bstat_v1.2/STEI_Bstat_v1.2.kicad_pcb (2026-08-07)

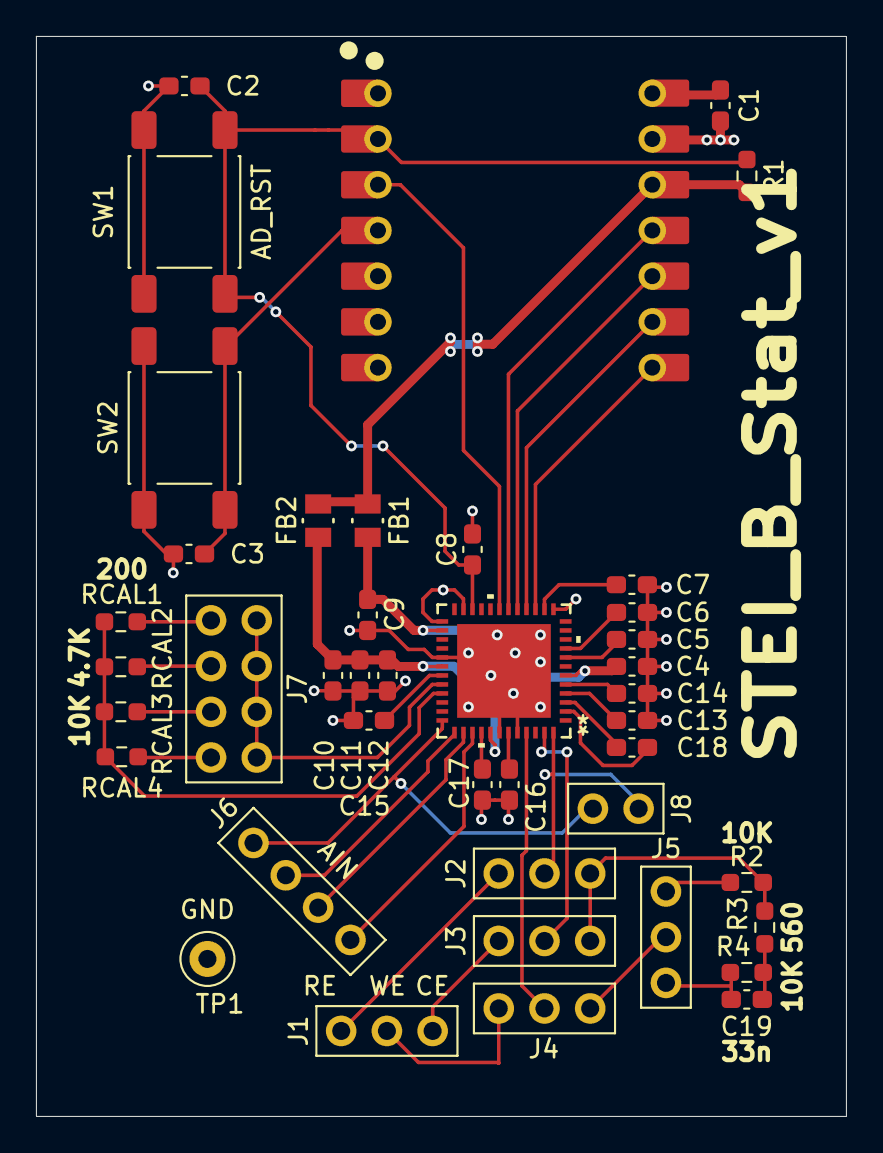
[picture p48: board STEI_Bstat_v1.2.kicad_pcb from above]

Board: 2 copper layers, 45.0 x 60.0 mm, 42 parts (0 on the bottom side), 43 nets.

Parts:
C1, C2, C3, C4, C5, C6, C8, C9, C10, C12, C17: 100n; C_0603_1608Metric_Pad1.08x0.95mm_HandSolder
C7, C13, C14, C15: 470n; C_0603_1608Metric_Pad1.08x0.95mm_HandSolder
C11: 10u; C_0603_1608Metric_Pad1.08x0.95mm_HandSolder
C16: 4,7u; C_0603_1608Metric_Pad1.08x0.95mm_HandSolder
C18: 220p; C_0603_1608Metric_Pad1.08x0.95mm_HandSolder
C19: 33n; C_0603_1608Metric_Pad1.08x0.95mm_HandSolder
FB1, FB2: FerriteBead; IND_BLM21_MUR
J1, J2, J3, J4, J5: Conn_01x03; PinHeader_1x03_P2.54mm_Vertical_NoGND
J6: Conn_01x04; PinHeader_1x04_P2.54mm_Vertical_NoGND
J7: Conn_02x04_Odd_Even; PinHeader_2x04_P2.54mm_Vertical_NoGND
J8: Conn_01x02; PinHeader_1x02_P2.54mm_Vertical_NoGND
R1, R2, R4: 10K; R_0603_1608Metric_Pad0.98x0.95mm_HandSolder
R3: 560; R_0603_1608Metric_Pad0.98x0.95mm_HandSolder
RCAL1: 200; R_0603_1608Metric_Pad0.98x0.95mm_HandSolder
RCAL2: 4.7K; R_0603_1608Metric_Pad0.98x0.95mm_HandSolder
RCAL3: 10K; R_0603_1608Metric_Pad0.98x0.95mm_HandSolder
RCAL4: R_0603_1608Metric_Pad0.98x0.95mm_HandSolder
SW1, SW2: SW_Push_Dual; SW_Push_1P1T_NO_E-Switch_TL3301NxxxxxG
TP1: TestPoint; TestPoint_Loop_D2.50mm_Drill1.0mm
U1: AD5941BCPZ; CP-48-4_ADI-L
U2: XIAO-RP2040-DIP

Connections:
3V3: FB1.2, FB2.1, R1.1, U2.12 (3V3)
AGND: C1.2, C2.2, C3.2, C4.2, C5.1, C6.1, C7.1, C8.1, C9.1, C10.2, C11.2, C12.2, C13.2, C14.2, C15.2, C16.2, C17.2, SW1.2, SW2.2, TP1.1 (1_1), U1.13 (DGND), U1.23 (DGND), U1.25 (DGND), U1.29 (AGND), U1.42 (AGND), U1.44 (AGND_REF), U1.49 (GND), U2.13 (GND)
AIN0: J6.1, U1.39 (AIN0)
AIN1: J6.2, U1.38 (AIN1)
AIN2: J6.3, U1.37 (AIN2)
AIN3: J6.4, J8.2, U1.36 (AIN3/BUF_VREF1V8)
AIN4/LPF0: C17.1, U1.40 (AIN4/LPF0)
AVDD: C10.1, C11.1, C12.1, FB2.2, U1.30 (AVDD), U1.41 (AVDD)
AVDD_REG: C14.1, U1.5 (AVDD_REG)
CE: J3.2, U1.47 (CE0)
CE_Dummy: J2.3, J3.3, R2.2, R3.2
CE_Pin: J1.3, J3.1
CS: U1.15 (CS), U2.8 (P1_D7_RX)
D3: C3.1, SW2.1, U2.4 (P29_A3_D3)
DVDD: C4.1, C9.2, FB1.1, U1.6 (DVDD), U1.26 (IOVDD)
DVDD_REG_AV8: C7.2, U1.14 (DVDD_REG_AV8)
GPIO0: U1.19 (GPIO0), U2.3 (P28_A2_D2)
MISO: U1.18 (MISO), U2.11 (P3_D10_MISO)
MOSI: U1.17 (MOSI), U2.10 (P4_D9_MOSI)
unnamed: C19.2, R3.1, R4.2
unnamed: J7.1, RCAL1.1
unnamed: J7.3, RCAL2.1
unnamed: J7.5, RCAL3.1
unnamed: J7.7, RCAL4.1
unnamed: C18.1, U1.3 (RC0_0)
unnamed: C18.2, U1.2 (RC0_1)
unnamed: C1.1, U2.14 (VBUS)
RCAL0(32): J7.2, J7.4, J7.6, J7.8, U1.32 (RCAL0)
RCAL1(33): RCAL1.2, RCAL2.2, RCAL3.2, RCAL4.2, U1.33 (RCAL1)
RE: J2.2, J8.1, U1.48 (RE0)
RESET: C2.1, C8.2, R1.2, SW1.1, U1.22 (RESET), U2.2 (P27_A1_D1)
RE_Pin: J1.1, J2.1
SCLK: U1.16 (SCLK), U2.9 (P2_D8_SCK)
VBIAS0: C5.2, U1.8 (VBIAS0)
VBIAS_CAP: C15.1, U1.31 (VBIAS_CAP)
VREF_1V8: C16.1, U1.43 (VREF_1V8)
VREF_2V5: C13.1, U1.4 (VREF_2V5)
VZERO0: C6.2, U1.9 (VZERO0)
WE: J4.2, U1.45 (SE0)
WE_Dummy: J4.3, J5.2
WE_Dummy1: J5.1, R2.1
WE_Dummy2: C19.1, J5.3, R4.1
WE_Pin: J1.2, J4.1
