mabooo18/Hunstat2/Software/HunStat2.ini

[Parameters]
ComComboBox=
cbLogVisible=1
edtStartE=-0.2
edtEndE=0.2
edtEStep=2
edtScanRate=0.1
edtCyclesNo=1
edtIRange=100
cbOCPCalibration=0
edtEISStartFreq=5
edtEISEndFreq=10000
edtEISDataPoints=10
edtEISAmplitudePP=10
edtEISBias=0
edtEISOffset=0
edtEISRCal=200
cbbEISTIARf=10k
cbEISPGA_GAIN=1.5
edtSmooth=25
edtELow=-1.65
edtEHigh=1.65
edtScanrateLow=0.003
edtScanrateHigh=2
edtOCPConstA=32816.01955
edtOCPConstB=26.97030925
