mabooo18/Hunstat2/Software/update 4 (8 Agustus 26)/AD5941_25/src/hardware/adc_control.h

#ifndef HUNSTAT_ADC_CONTROL_H
#define HUNSTAT_ADC_CONTROL_H

#include <Arduino.h>
#include "../../AD5940.h"

void Hardware_Init_AD5940_ADC(float freq);

inline void init_AD5940_ADC(float freq)
{
	Hardware_Init_AD5940_ADC(freq);
}

#endif
