mabooo18/Hunstat2/Software/update 4 (8 Agustus 26)/AD5941_25/src/hardware/wave_gen.cpp

// Waveform generator control module. Sets up internal sinusoidal generators for EIS AC excitation.

#include "wave_gen.h"
#include "gain_control.h"

// Access global variables from the orchestrator
extern uint32_t _CGmax;
extern uint32_t _CGmin;
extern bool use_variable_gain;
extern uint8_t pga_gain;
extern uint8_t tia_rf;
extern uint32_t SYS_CLOCK_HZ;
extern bool SeeedStatMode;
extern HSLoopCfg_Type HpLoopCfg;
extern ADCBaseCfg_Type adc_base;
extern CLKCfg_Type clk_cfg;
extern AFERefCfg_Type aferef_cfg;
extern uint16_t offset;
extern uint8_t EIS_mode;
extern uint16_t amplitude;
extern uint16_t vbias;
extern uint16_t frequency;
extern uint32_t verbose;

/**
 * @brief Sets up AFE clock, references, gains, matrix switches, and sinusoidal parameters.
 * @param mode 0 = measurement Rz (working cell), 1 = measurement Rcal (calibration resistor).
 * @param frequency AC frequency in Hz.
 * @param amplitude Sine wave AC amplitude digital code.
 * @param tia_code Default TIA resistor feedback code.
 */
void Hardware_Do_WaveGen(uint8_t mode, float frequency, uint16_t amplitude, uint8_t tia_code)
{
    if (SeeedStatMode) {
        digitalWrite(D4, HIGH); // Assert logic indicator pin D4 high during configuration
    }

    uint8_t _TIA_Rf, _PGA_gain;
    float closest_CG;

    // Step 1: Configure base clock settings (High-Frequency 16MHz clock)
    clk_cfg.ADCClkDiv = ADCCLKDIV_1;
    clk_cfg.ADCCLkSrc = ADCCLKSRC_HFOSC;
    clk_cfg.SysClkDiv = SYSCLKDIV_1;
    clk_cfg.SysClkSrc = SYSCLKSRC_HFOSC;
    clk_cfg.HfOSC32MHzMode = bFALSE;
    clk_cfg.HFOSCEn = bTRUE;
    clk_cfg.HFXTALEn = bFALSE;
    clk_cfg.LFOSCEn = bTRUE;
    AD5940_CLKCfg(&clk_cfg);

    // Step 2: Configure internal low-drift Bandgap Voltage References
    aferef_cfg.HpBandgapEn = bTRUE;          // Enable High-Power bandgap reference
    aferef_cfg.Hp1V1BuffEn = bTRUE;          // Enable 1.11V reference buffer
    aferef_cfg.Hp1V8BuffEn = bTRUE;          // Enable 1.82V reference buffer
    aferef_cfg.Disc1V1Cap = bFALSE;
    aferef_cfg.Disc1V8Cap = bFALSE;
    aferef_cfg.Hp1V8ThemBuff = bFALSE;
    aferef_cfg.Hp1V8Ilimit = bFALSE;
    aferef_cfg.Lp1V1BuffEn = bFALSE;
    aferef_cfg.Lp1V8BuffEn = bFALSE;
    aferef_cfg.LpBandgapEn = bTRUE;          // Enable Low-Power reference bandgap
    aferef_cfg.LpRefBufEn = bTRUE;           // Enable Low-Power reference buffer
    aferef_cfg.LpRefBoostEn = bFALSE;
    AD5940_REFCfgS(&aferef_cfg);

    // Step 3: Configure HS TIA baseline parameters
    HpLoopCfg.HsTiaCfg.DiodeClose = bFALSE;
    HpLoopCfg.HsTiaCfg.HstiaBias = HSTIABIAS_1P1;
    HpLoopCfg.HsTiaCfg.HstiaCtia = 16;       // 16pF capacitor
    HpLoopCfg.HsTiaCfg.HstiaDeRload = HSTIADERLOAD_OPEN;
    HpLoopCfg.HsTiaCfg.HstiaDeRtia = HSTIADERTIA_TODE;

    // Step 4: Resolve gain and feedback resistor selections
    if (use_variable_gain) {
        // Automatically choose TIA Rf and PGA gain based on target combined gain (CG)
        Hardware_FindOptimum_Rf_PGA(_CGmax, _CGmin, frequency, &_TIA_Rf, &_PGA_gain, &closest_CG);
        HpLoopCfg.HsTiaCfg.HstiaRtiaSel = _TIA_Rf;
        adc_base.ADCPga = _PGA_gain;
    }
    else {
        // Use user-defined static values
        HpLoopCfg.HsTiaCfg.HstiaRtiaSel = tia_code;
        adc_base.ADCPga = pga_gain;
    }
    AD5940_ADCBaseCfgS(&adc_base);

    // Step 5: Configure Matrix Switches depending on target measurement mode
    if (mode == 0) {
        // Mode 0: Route paths for Working Cell measurements (Rz)
        HpLoopCfg.SWMatCfg.Dswitch = SWD_CE0;
        HpLoopCfg.SWMatCfg.Pswitch = SWP_RE0;
        HpLoopCfg.SWMatCfg.Nswitch = SWN_SE0;
        HpLoopCfg.SWMatCfg.Tswitch = SWT_TRTIA | SWT_SE0LOAD;
    }
    else {
        // Mode 1: Route paths for Calibration Resistor measurements (Rcal)
        HpLoopCfg.SWMatCfg.Dswitch = SWD_RCAL0;
        HpLoopCfg.SWMatCfg.Pswitch = SWP_RCAL0;
        HpLoopCfg.SWMatCfg.Nswitch = SWN_RCAL1;
        HpLoopCfg.SWMatCfg.Tswitch = SWT_TRTIA | SWT_RCAL1;
    }

    // Step 6: Configure Sinusoidal Waveform Generator parameters
    AD5940_AFECtrlS(AFECTRL_WG, bFALSE); // Disable generator during configuration updates

    HpLoopCfg.WgCfg.WgType = WGTYPE_SIN; // Select sinusoidal generator
    HpLoopCfg.WgCfg.GainCalEn = bFALSE;
    HpLoopCfg.WgCfg.OffsetCalEn = bFALSE;
    
    // Calculate frequency word based on current clock frequency
    HpLoopCfg.WgCfg.SinCfg.SinFreqWord = AD5940_WGFreqWordCal(frequency, SYS_CLOCK_HZ);
    HpLoopCfg.WgCfg.SinCfg.SinAmplitudeWord = amplitude;
    HpLoopCfg.WgCfg.SinCfg.SinOffsetWord = offset;
    HpLoopCfg.WgCfg.SinCfg.SinPhaseWord = 0;
    AD5940_HSLoopCfgS(&HpLoopCfg);

    // Step 7: Power up amplifiers and activate generator output
    AD5940_AFECtrlS(AFECTRL_DACREFPWR, bTRUE);
    AD5940_AFECtrlS(AFECTRL_EXTBUFPWR | AFECTRL_INAMPPWR | AFECTRL_HSTIAPWR | AFECTRL_HSDACPWR, bTRUE);
    AD5940_AFECtrlS(AFECTRL_WG, bTRUE);
    AD5940_AFECtrlS(AFECTRL_DCBUFPWR, bTRUE);
    AD5940_AFEPwrBW(AFEPWR_LP, AFEBW_250KHZ); // Set low-power loop bandwidth

    if (SeeedStatMode) {
        digitalWrite(D4, LOW); // Deassert indicator pin D4
    }
}
