mabooo18/Hunstat2/(commit log)

2026-07-10 Refactor HunStat2: modular C++ architecture, interactive Python test UI, offline unit tests, and comprehensive documentation
    [HunSta2_BOM_corr.xlsx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]
2026-07-11 Add system call-flow flowchart (FLOWCHART.md)
2026-07-11 Update FLOWCHART.md with compatible Mermaid syntax
2026-08-07 Add update journal and Software/update 4 (8 Agustus 26)
    [STEI_Bstat_v1.2.kicad_pcb, STEI_Bstat_v1.2.kicad_sch, bom-1.csv, ca_final_step_0to200mV.csv, ca_fix2_-100.csv, ca_fix2_-50.csv, ca_fix2_100.csv, ca_fix2_200.csv]
